RakibMahmud2003/Forward-Propulsion-Using-Ionic-Thruster/Media/Entire Setup.jpg

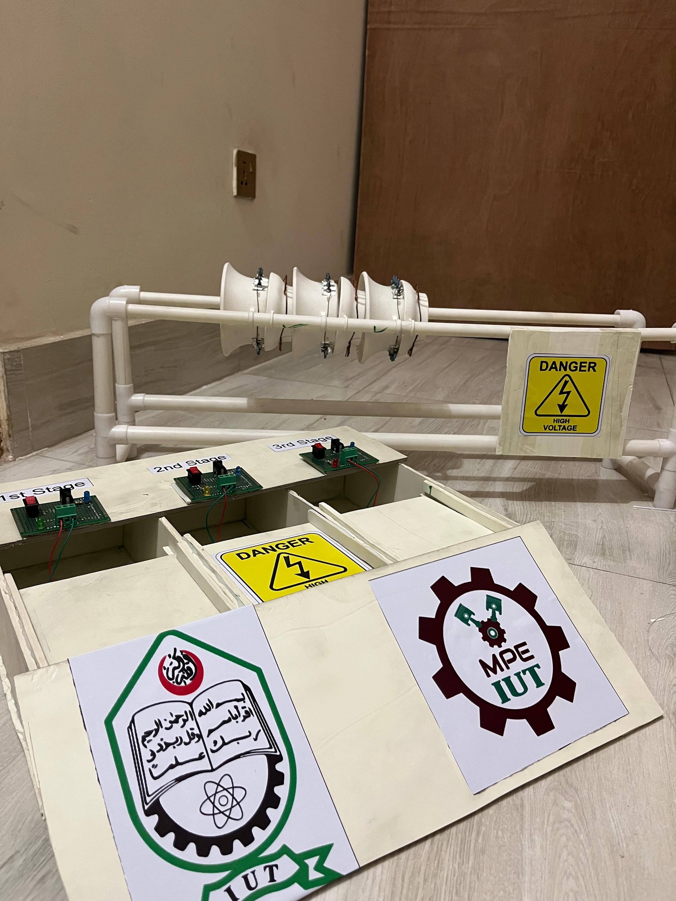
Media/Entire Setup.jpg
