RakibMahmud2003/Forward-Propulsion-Using-Ionic-Thruster/Media/Single Stage Assembly.jpeg

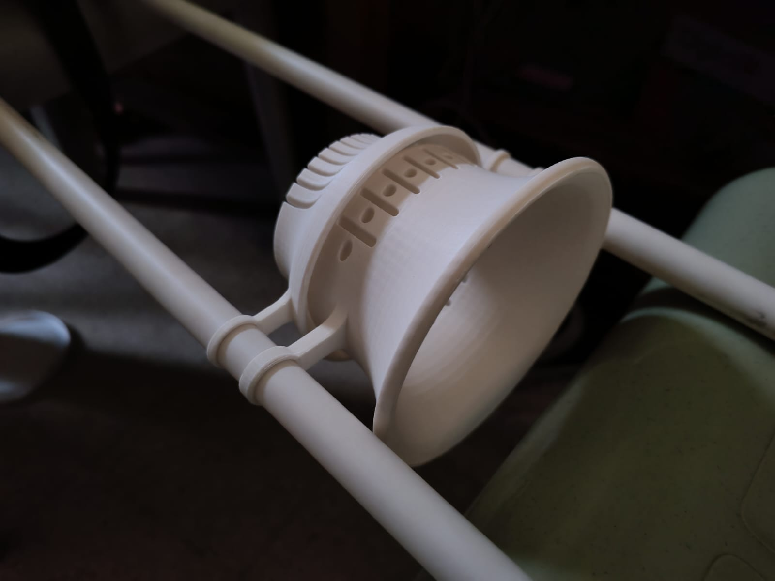
Media/Single Stage Assembly.jpeg
