RakibMahmud2003/Forward-Propulsion-Using-Ionic-Thruster/Contributors/1772908971167.jpeg

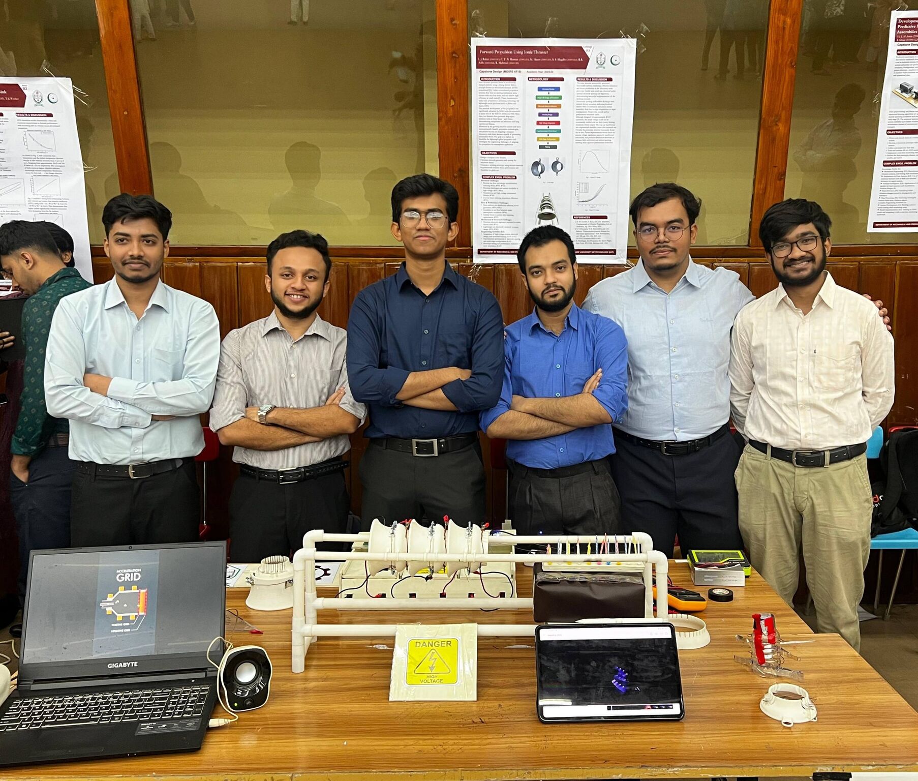
Contributors/1772908971167.jpeg
