RakibMahmud2003/Forward-Propulsion-Using-Ionic-Thruster/Media/Electric Box.jpeg

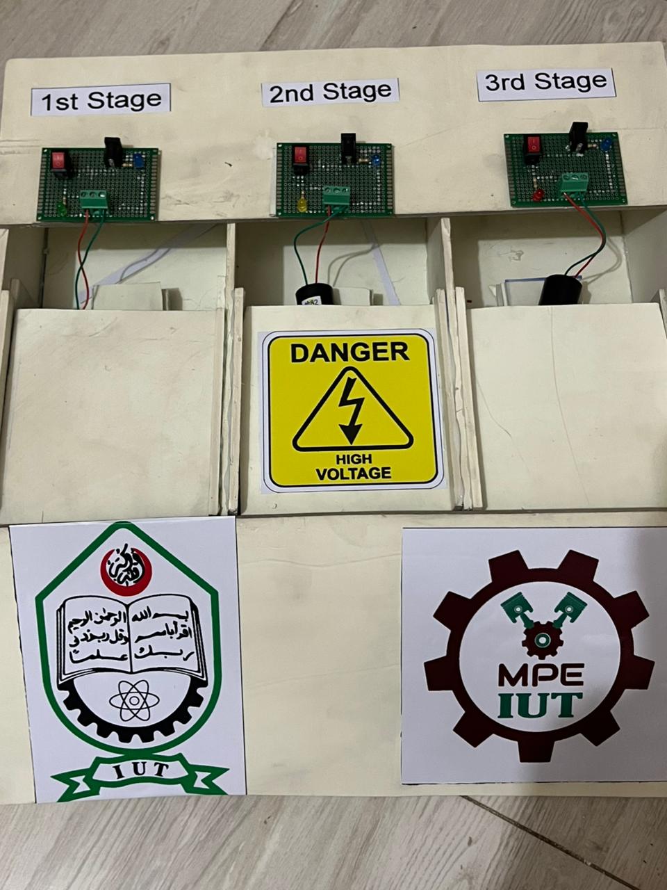
Media/Electric Box.jpeg
