RakibMahmud2003/Forward-Propulsion-Using-Ionic-Thruster/Media/Isometric View.jpeg

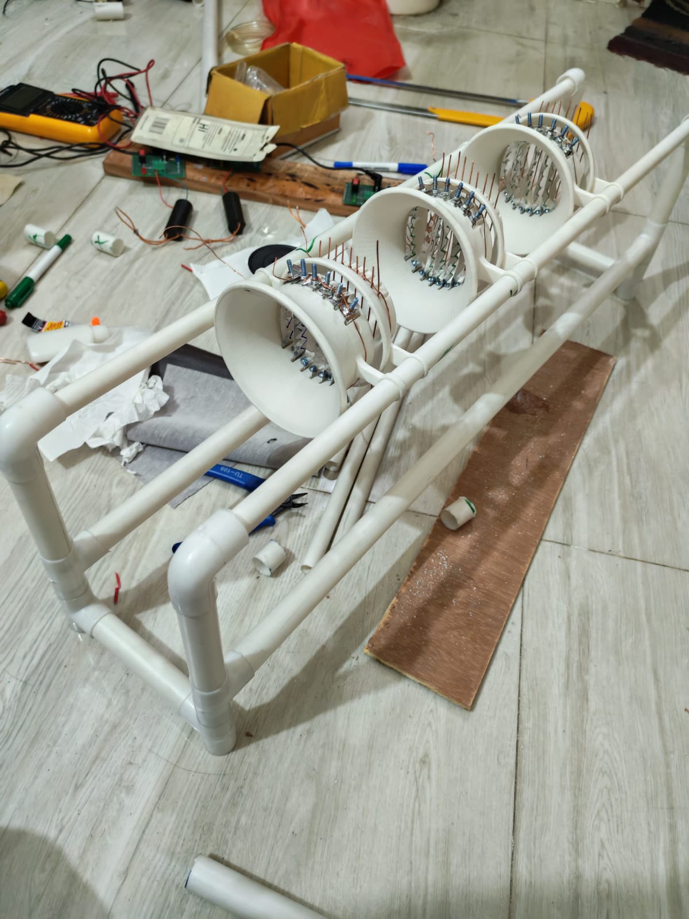
Media/Isometric View.jpeg
