RakibMahmud2003/Forward-Propulsion-Using-Ionic-Thruster/Media/Positive and Negative Electrode Holders.jpeg

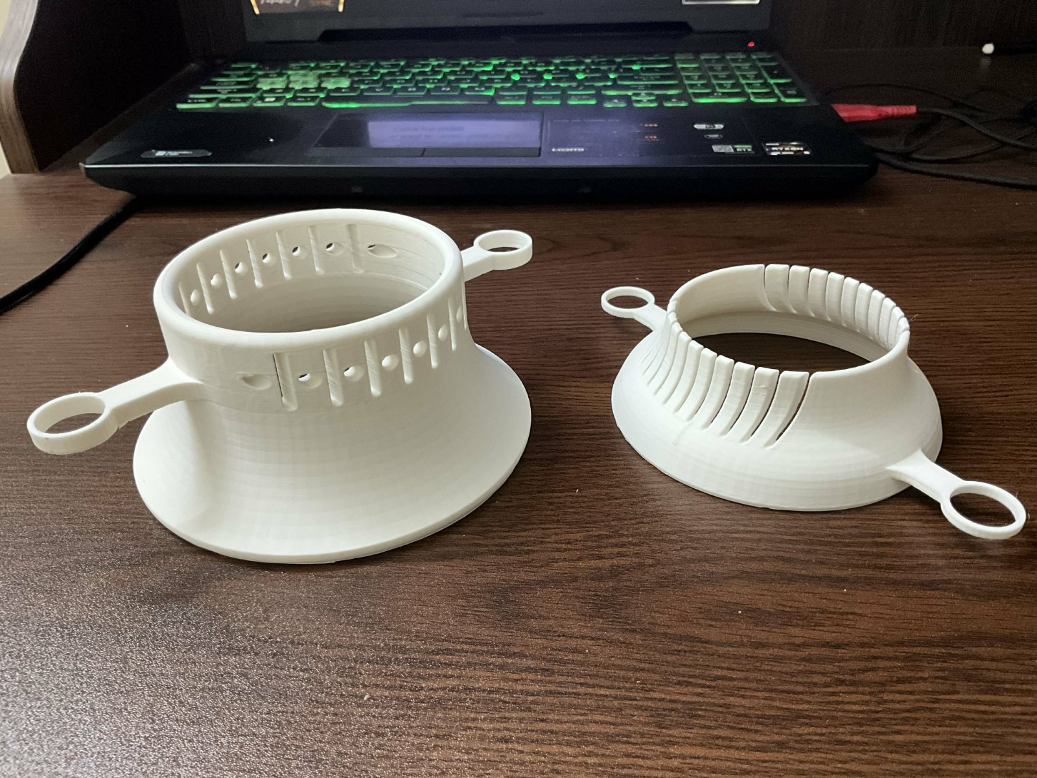
Media/Positive and Negative Electrode Holders.jpeg
