RakibMahmud2003/Forward-Propulsion-Using-Ionic-Thruster/Draft Designs/Draft 1/Assembly.SLDASM

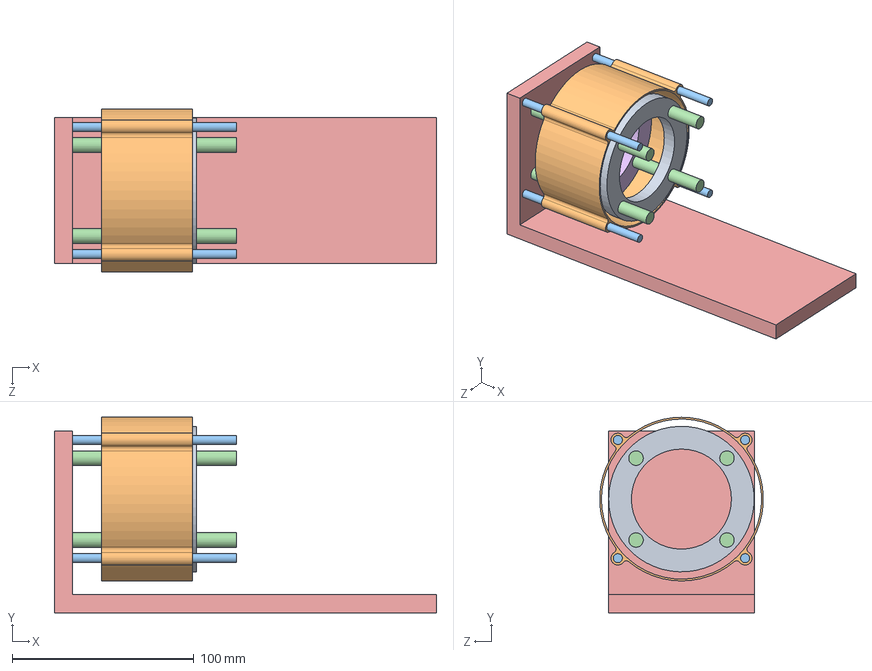
[picture p26: CAD file, 2026-03-18]
Draft Designs/Draft 1/Assembly.SLDASM
210.0 x 107.5 x 89.9 mm
AnodeHolder
Base
rod x 4
5mm rod x 4
Cover
CatHolder
