RakibMahmud2003/Forward-Propulsion-Using-Ionic-Thruster/Simulation & Validation Designs/Iteration 2/Assembly.SLDASM

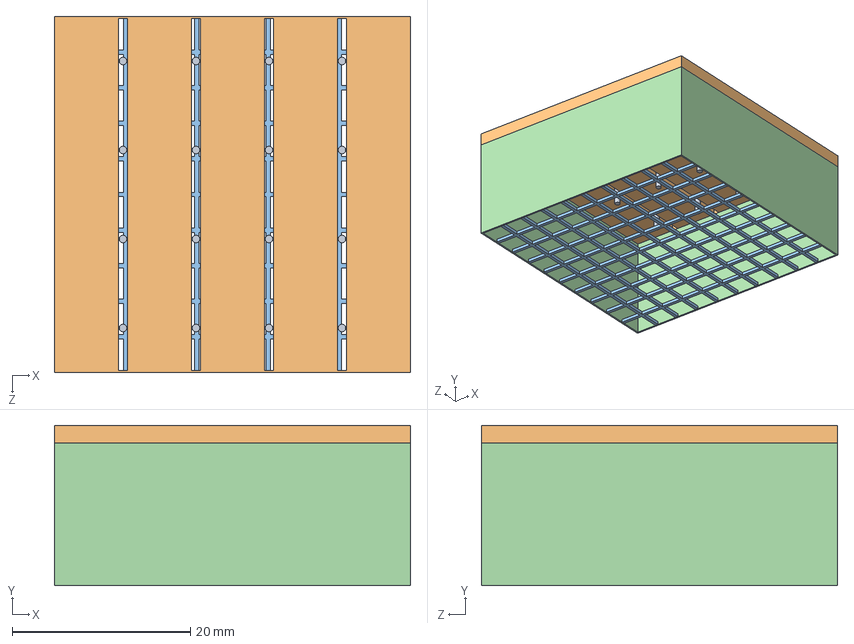
[picture p27: CAD file, 2026-03-18]
Simulation & Validation Designs/Iteration 2/Assembly.SLDASM
40.0 x 18.0 x 40.0 mm
Main Air Domain
Collector Electrode Board
Top Lid 2
Needles 1 row x 4
