RakibMahmud2003/Forward-Propulsion-Using-Ionic-Thruster/Draft Designs/Draft 2/Assem.SLDASM

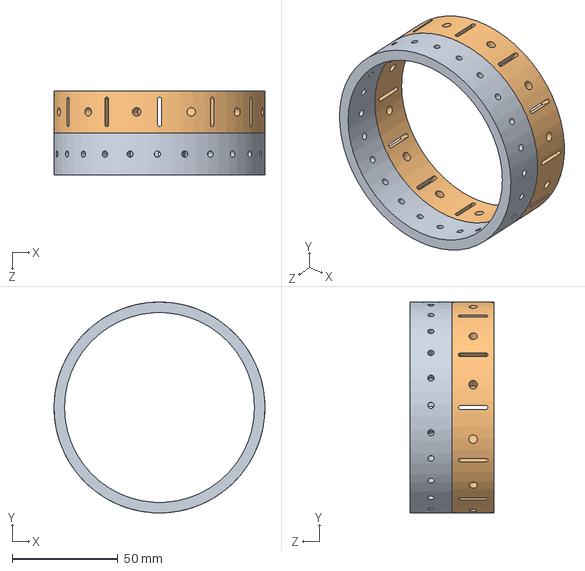
[picture p28: CAD file, 2026-03-18]
Draft Designs/Draft 2/Assem.SLDASM
100.0 x 100.0 x 40.0 mm
Anode
Cathod
