RakibMahmud2003/Forward-Propulsion-Using-Ionic-Thruster/Proposed Design/Assembly.SLDASM

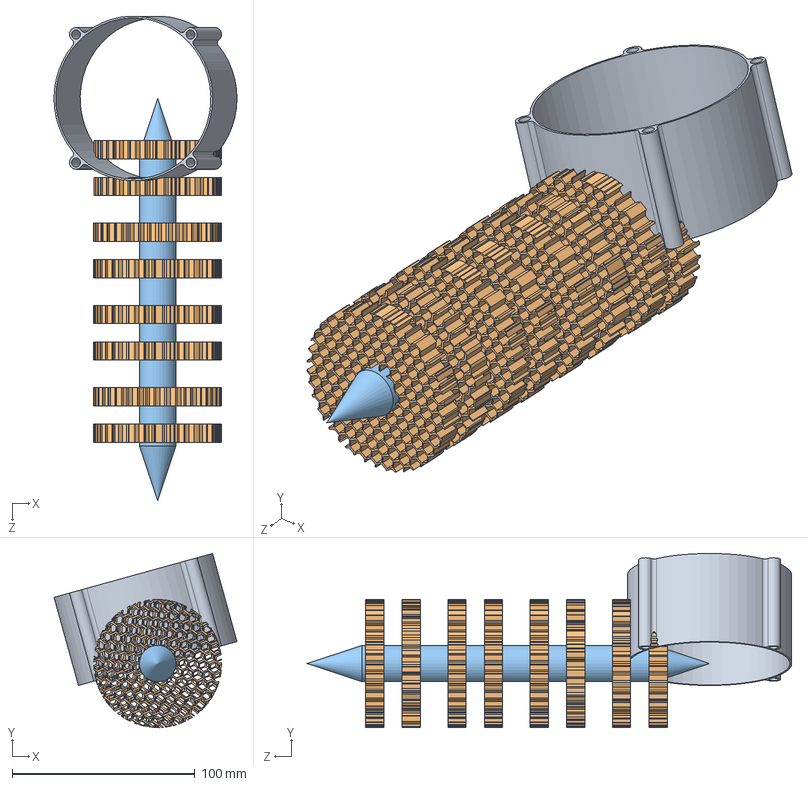
[picture p29: CAD file, 2026-03-18]
Proposed Design/Assembly.SLDASM
100.1 x 95.2 x 264.9 mm
Core
Comb x 8
Cover
