RakibMahmud2003/Forward-Propulsion-Using-Ionic-Thruster/Simulation & Validation Designs/Iteration 2/Main Air Domain.SLDPRT

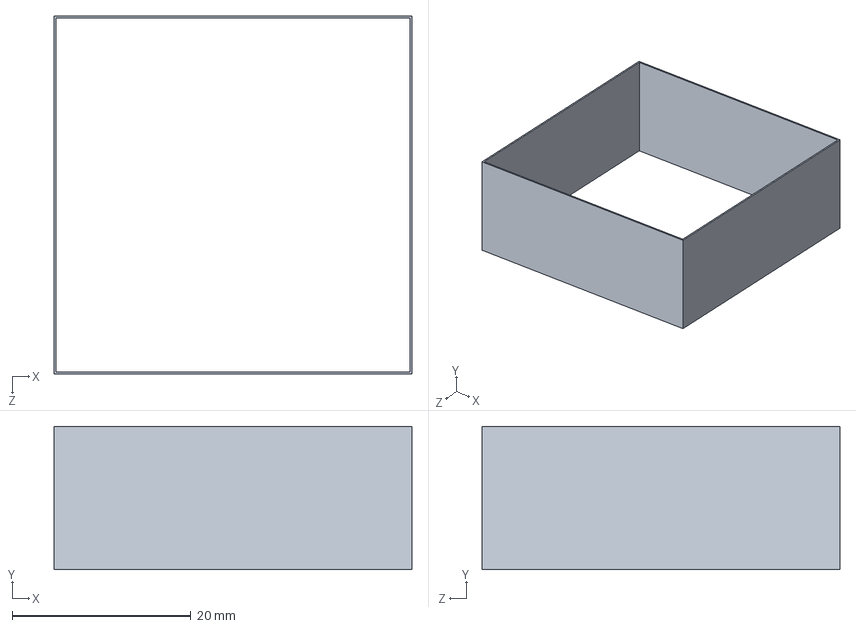
[picture p30: CAD file, 2026-03-18]
Simulation & Validation Designs/Iteration 2/Main Air Domain.SLDPRT
40.0 x 16.0 x 40.0 mm
