RakibMahmud2003/Forward-Propulsion-Using-Ionic-Thruster/Draft Designs/Draft 2/Anode.SLDPRT

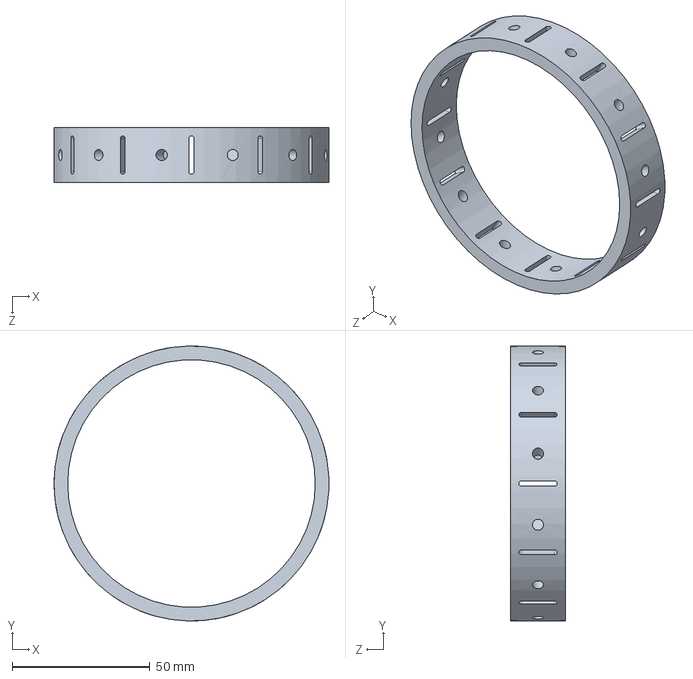
[picture p31: CAD file, 2026-03-18]
Draft Designs/Draft 2/Anode.SLDPRT
100.0 x 100.0 x 20.0 mm
