RakibMahmud2003/Forward-Propulsion-Using-Ionic-Thruster/Manufacturable Designs/Iteration 3/Step Files/Positive-3.STEP

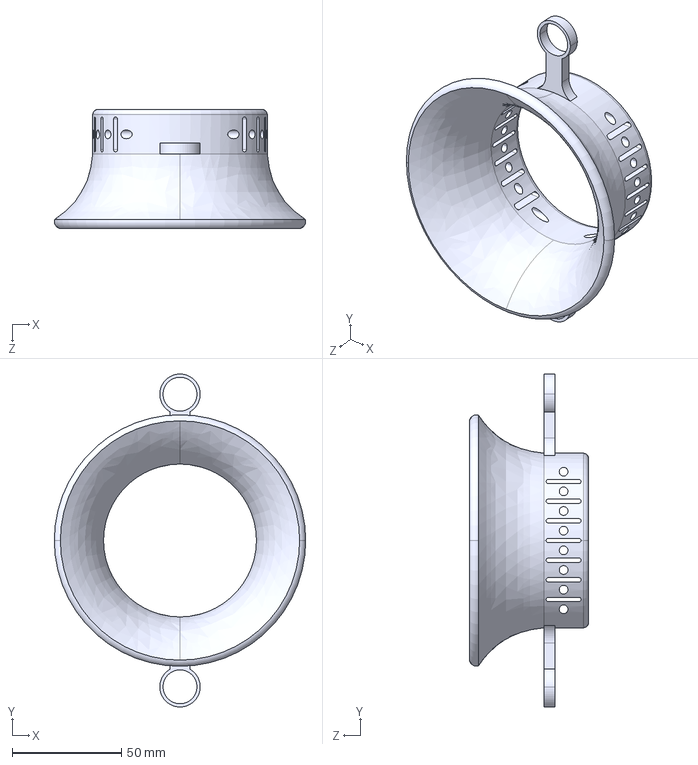
[picture p32: CAD file, 2026-03-18]
Manufacturable Designs/Iteration 3/Step Files/Positive-3.STEP
115.2 x 152.5 x 54.7 mm
