RakibMahmud2003/Forward-Propulsion-Using-Ionic-Thruster/Proposed Design/Comb.SLDPRT

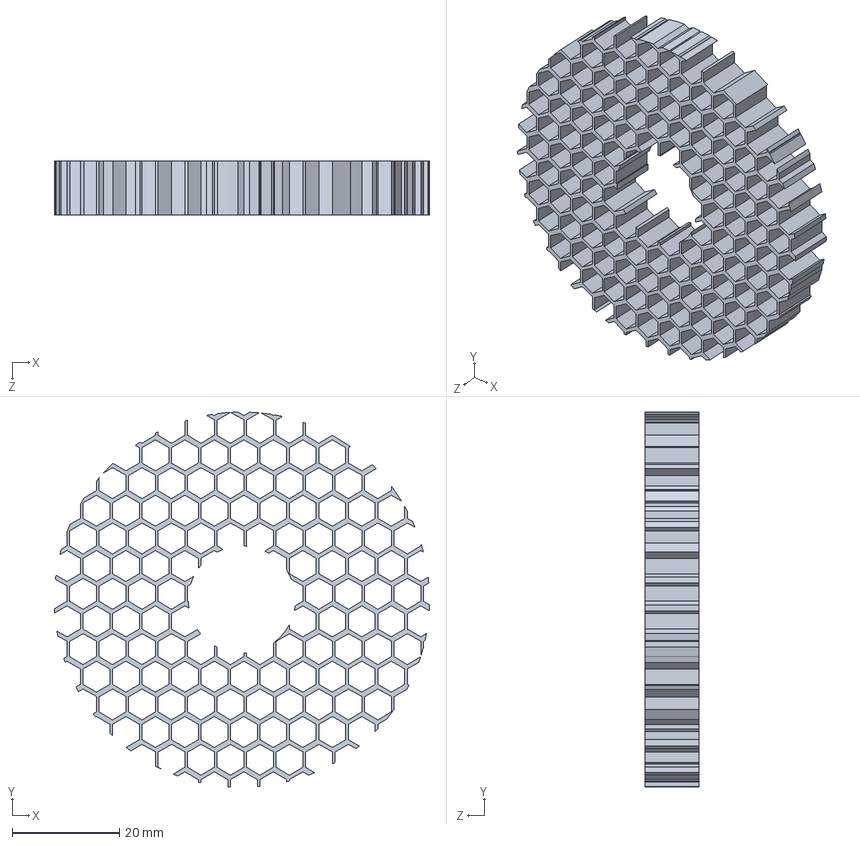
[picture p33: CAD file, 2026-03-18]
Proposed Design/Comb.SLDPRT
69.9 x 69.9 x 10.0 mm
