RakibMahmud2003/Forward-Propulsion-Using-Ionic-Thruster/Draft Designs/Draft 1/Part1.SLDPRT

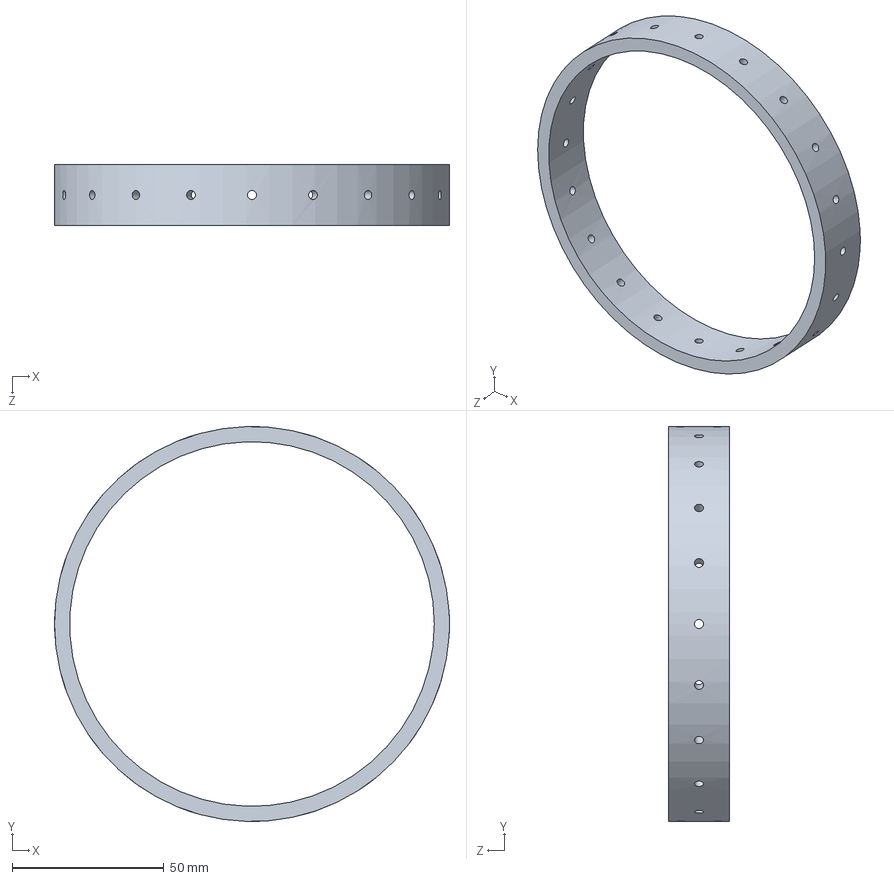
[picture p34: CAD file, 2026-03-18]
Draft Designs/Draft 1/Part1.SLDPRT
130.0 x 130.0 x 20.0 mm
