RakibMahmud2003/Forward-Propulsion-Using-Ionic-Thruster/Manufacturable Designs/Iteration 3/Step Files/Negative-3.STEP

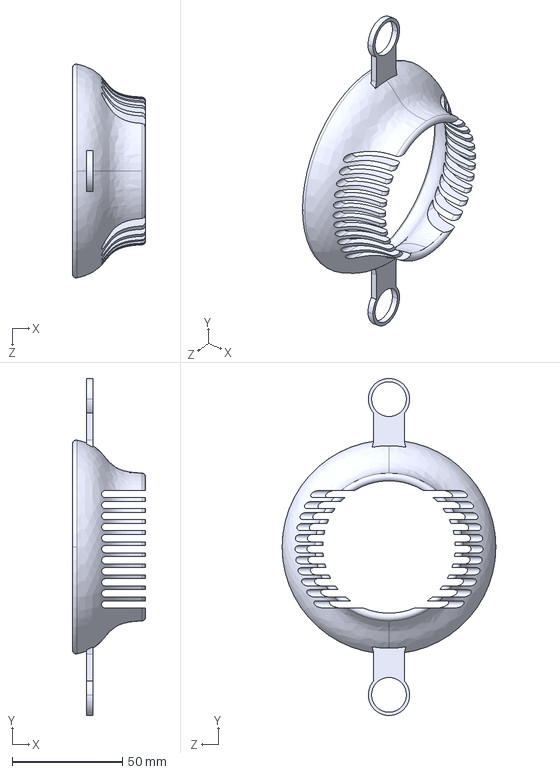
[picture p35: CAD file, 2026-03-18]
Manufacturable Designs/Iteration 3/Step Files/Negative-3.STEP
33.2 x 152.8 x 96.9 mm
