RakibMahmud2003/Forward-Propulsion-Using-Ionic-Thruster/Draft Designs/Draft 1/CatHolder.SLDPRT

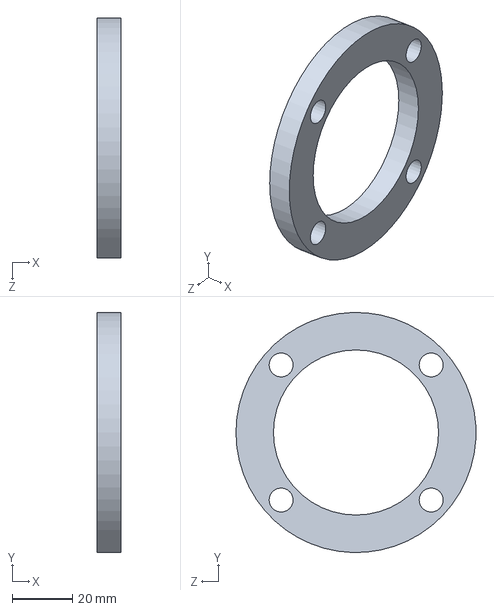
[picture p37: CAD file, 2026-03-18]
Draft Designs/Draft 1/CatHolder.SLDPRT
8.00 x 80.0 x 80.0 mm
