RakibMahmud2003/Forward-Propulsion-Using-Ionic-Thruster/Draft Designs/Draft 2/Cathod.SLDPRT

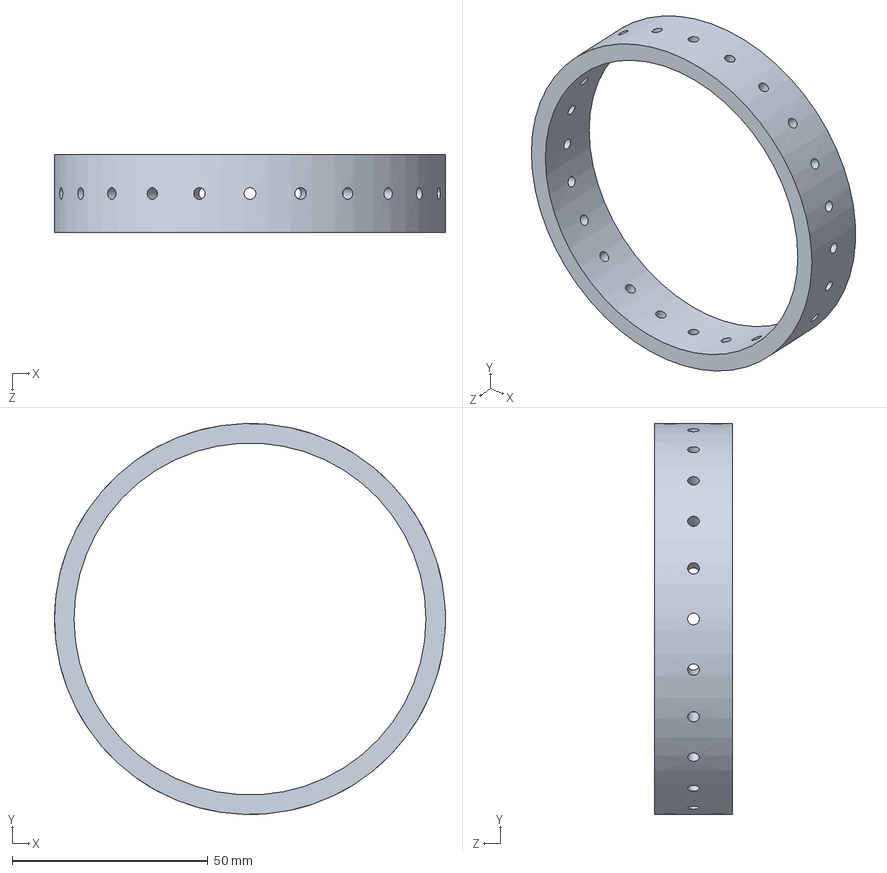
[picture p38: CAD file, 2026-03-18]
Draft Designs/Draft 2/Cathod.SLDPRT
100.0 x 100.0 x 20.0 mm
