RakibMahmud2003/Forward-Propulsion-Using-Ionic-Thruster/Proposed Design/Core.SLDPRT

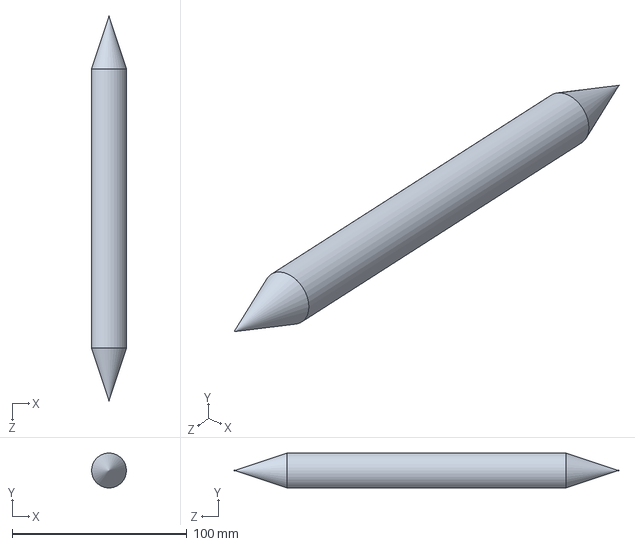
[picture p39: CAD file, 2026-03-18]
Proposed Design/Core.SLDPRT
20.0 x 19.9 x 220.0 mm
