RakibMahmud2003/Forward-Propulsion-Using-Ionic-Thruster/Draft Designs/Draft 1/Cover.SLDPRT

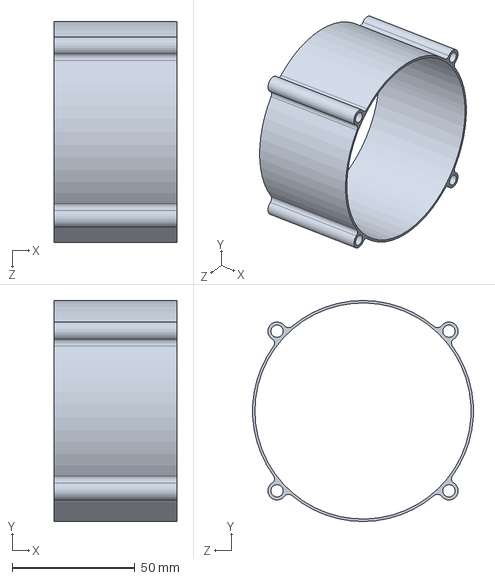
[picture p40: CAD file, 2026-03-18]
Draft Designs/Draft 1/Cover.SLDPRT
50.0 x 90.0 x 89.9 mm
