RakibMahmud2003/Forward-Propulsion-Using-Ionic-Thruster/Proposed Design/Cover.SLDPRT

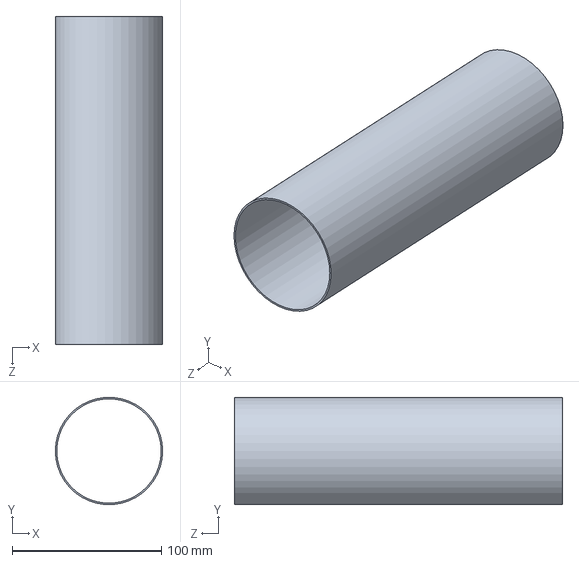
[picture p41: CAD file, 2026-03-18]
Proposed Design/Cover.SLDPRT
72.0 x 71.8 x 220.0 mm
