RakibMahmud2003/Forward-Propulsion-Using-Ionic-Thruster/Simulation & Validation Designs/Iteration 2/New Top Lid.SLDPRT

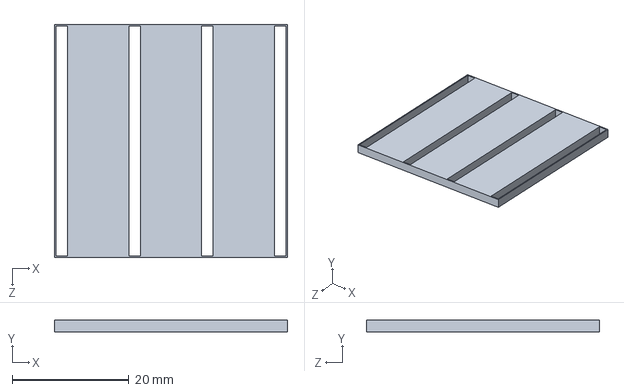
[picture p42: CAD file, 2026-03-18]
Simulation & Validation Designs/Iteration 2/New Top Lid.SLDPRT
40.0 x 2.00 x 40.0 mm
