RakibMahmud2003/Forward-Propulsion-Using-Ionic-Thruster/Simulation & Validation Designs/Iteration 2/Needles 1 row.SLDPRT

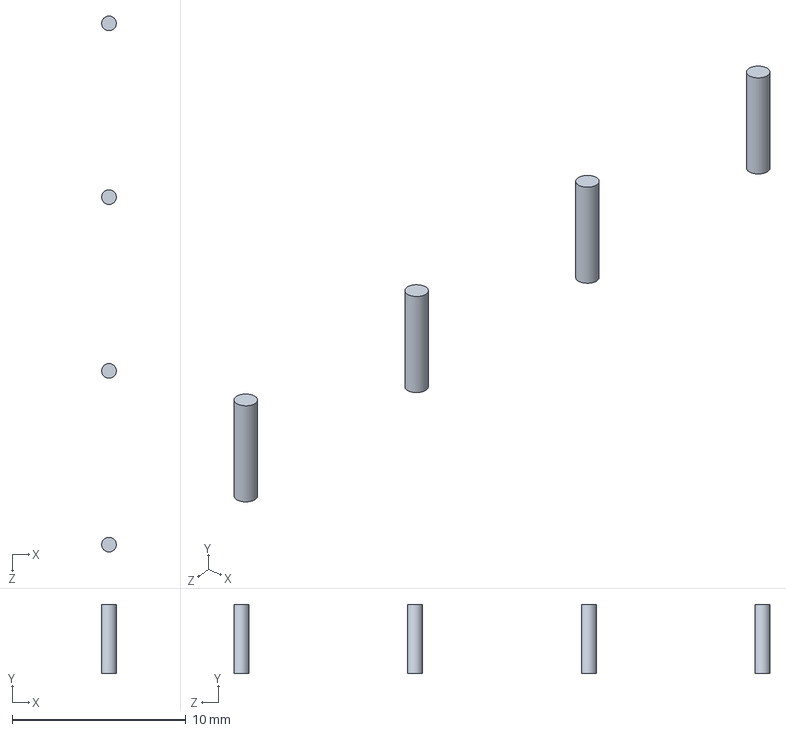
[picture p43: CAD file, 2026-03-18]
Simulation & Validation Designs/Iteration 2/Needles 1 row.SLDPRT
0.85 x 4.00 x 30.9 mm
