RakibMahmud2003/Forward-Propulsion-Using-Ionic-Thruster/Draft Designs/Draft 1/rod.SLDPRT

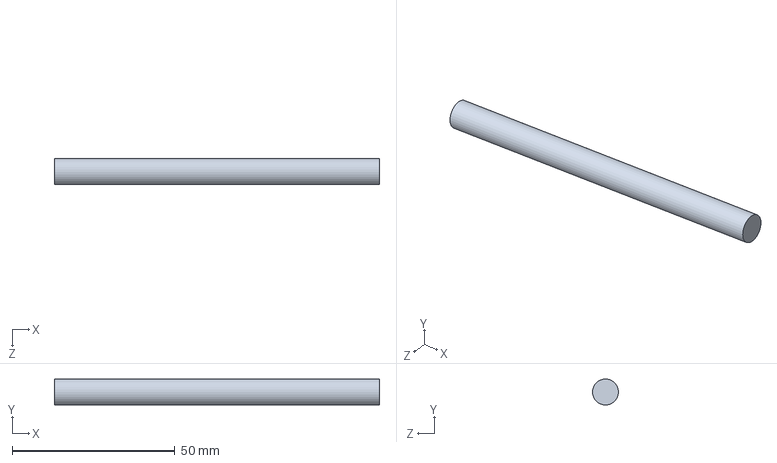
[picture p44: CAD file, 2026-03-18]
Draft Designs/Draft 1/rod.SLDPRT
100.0 x 7.99 x 8.00 mm
