RakibMahmud2003/Forward-Propulsion-Using-Ionic-Thruster/Simulation & Validation Designs/Iteration 2/Needles.SLDPRT

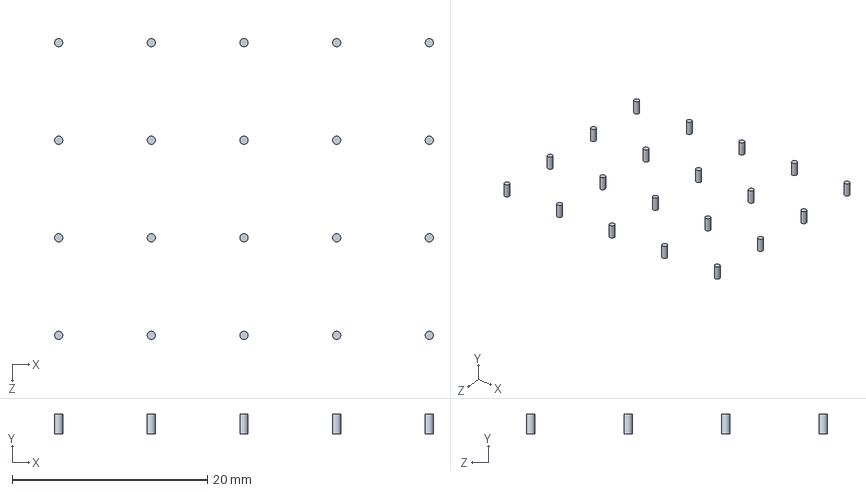
[picture p45: CAD file, 2026-03-18]
Simulation & Validation Designs/Iteration 2/Needles.SLDPRT
38.9 x 2.00 x 30.9 mm
