RakibMahmud2003/Forward-Propulsion-Using-Ionic-Thruster/Draft Designs/Draft 1/Base.SLDPRT

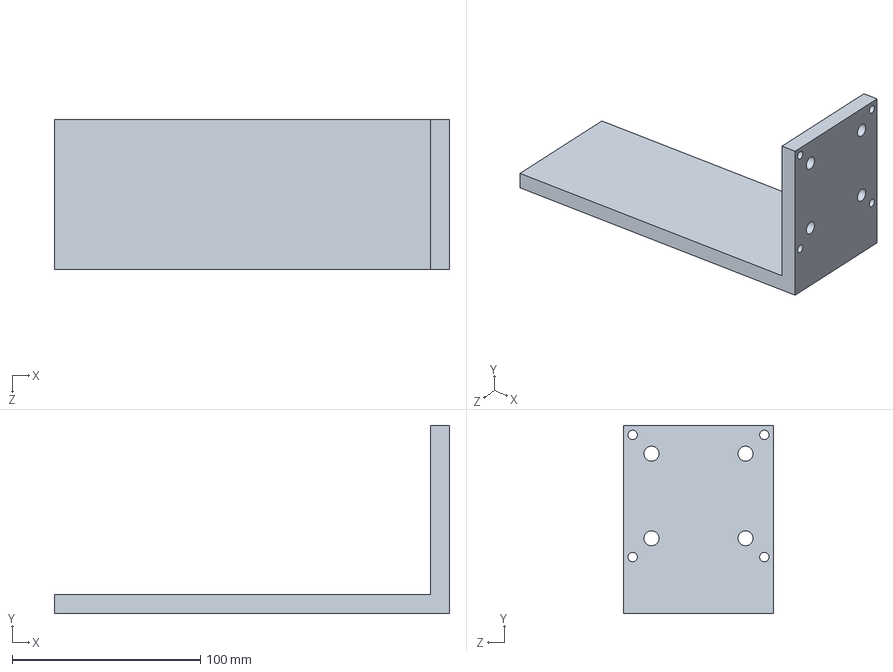
[picture p46: CAD file, 2026-03-18]
Draft Designs/Draft 1/Base.SLDPRT
210.0 x 100.0 x 80.0 mm
