RakibMahmud2003/Forward-Propulsion-Using-Ionic-Thruster/Simulation & Validation Designs/Iteration 2/Collector Electrode Board.SLDPRT

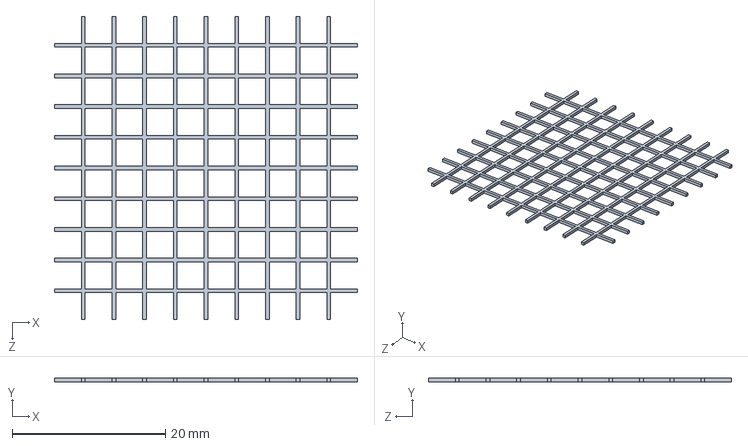
[picture p47: CAD file, 2026-03-18]
Simulation & Validation Designs/Iteration 2/Collector Electrode Board.SLDPRT
39.5 x 0.5 x 39.5 mm
