RakibMahmud2003/Forward-Propulsion-Using-Ionic-Thruster/Draft Designs/Draft 1/5mm rod.SLDPRT

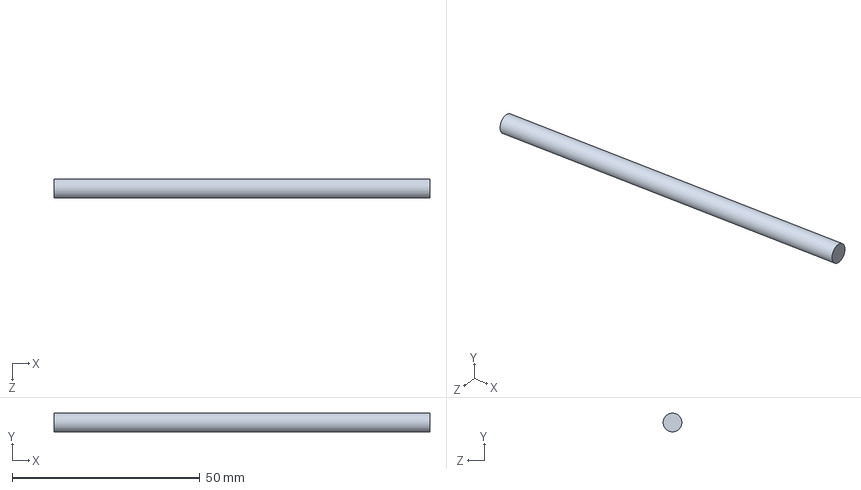
[picture p48: CAD file, 2026-03-18]
Draft Designs/Draft 1/5mm rod.SLDPRT
100.0 x 4.99 x 5.00 mm
