RakibMahmud2003/Forward-Propulsion-Using-Ionic-Thruster/Simulation & Validation Designs/Iteration 2/Metal Strip.SLDPRT

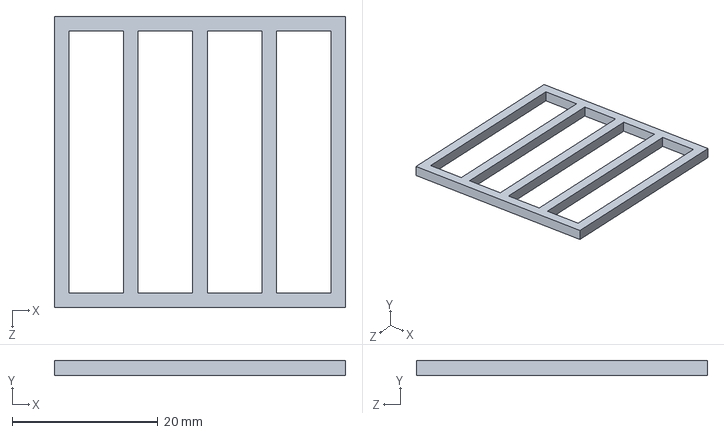
[picture p49: CAD file, 2026-03-18]
Simulation & Validation Designs/Iteration 2/Metal Strip.SLDPRT
40.0 x 2.00 x 40.0 mm
