RakibMahmud2003/Forward-Propulsion-Using-Ionic-Thruster/(list of files, cad)

Other CAD files:
Draft Designs/Draft 1/AnodeHolder.SLDPRT
Manufacturable Designs/Iteration 1/Part Files/Assembly.SLDASM
Manufacturable Designs/Iteration 1/Part Files/Negative.SLDPRT
Manufacturable Designs/Iteration 1/Part Files/Positive.SLDPRT
Manufacturable Designs/Iteration 1/STL Files/Negative.STL
Manufacturable Designs/Iteration 1/STL Files/Positive.STL
Manufacturable Designs/Iteration 2/Part Files/Assem2.SLDASM
Manufacturable Designs/Iteration 2/Part Files/Negative-2.SLDPRT
Manufacturable Designs/Iteration 2/Part Files/Positive-2.SLDPRT
Manufacturable Designs/Iteration 2/STL Files/Negative-2.STL
Manufacturable Designs/Iteration 2/STL Files/Positive-2.STL
Manufacturable Designs/Iteration 2/Step Files/Assembly.SLDASM
Manufacturable Designs/Iteration 2/Step Files/Negative-2.STEP
Manufacturable Designs/Iteration 2/Step Files/Positive-2.STEP
Manufacturable Designs/Iteration 3/STL Files/Negative-3.STL
Manufacturable Designs/Iteration 3/STL Files/Positive-3.STL
Simulation & Validation Designs/Iteration 1/Assembly 2.0.SLDASM
